armtronix/Wifi_Three_Triac_Board/Arduino_Code/Wifi_Triac_One_dimmable_Two_On_Off_V0.1/serverFunctions.ino

void initWiFi(){
  Serial.println();
  Serial.println();
  Serial.println("Startup");
  
  // test esid 
  WiFi.disconnect();
  delay(100);
  WiFi.mode(WIFI_STA);
  Serial.print("Connecting to WiFi ");
  Serial.println(esid);
  Debugln(epass);
  WiFi.begin((char*)esid.c_str(), (char*)epass.c_str());
  if ( testWifi() == 20 ) { 
      launchWeb(0);
      return;
  }
  Serial.println("Opening AP");
  setupAP();   
}

int testWifi(void) {
  int c = 0;
  Debugln("Wifi test...");  
  while ( c < 30 ) {
    if (WiFi.status() == WL_CONNECTED) { return(20); } 
    delay(500);
    Serial.print(".");    
    c++;
  }
  Serial.println("WiFi Connect timed out!");
  return(10);
} 


void setupAP(void) {
  
  WiFi.mode(WIFI_STA);
  WiFi.disconnect();
  delay(100);
  int n = WiFi.scanNetworks();
  Serial.println("scan done");
  if (n == 0){
    Serial.println("no networks found");
    st ="<b>No networks found:</b>";
  } else {
    Serial.print(n);
    Serial.println(" Networks found");
    st = "<ul>";
    for (int i = 0; i < n; ++i)
     {
      // Print SSID and RSSI for each network found
      Serial.print(i + 1);
      Serial.print(": ");
      Serial.print(WiFi.SSID(i));
      Serial.print(" (");
      Serial.print(WiFi.RSSI(i));
      Serial.print(")");
      Serial.println((WiFi.encryptionType(i) == ENC_TYPE_NONE)?" (OPEN)":"*");
      
      // Print to web SSID and RSSI for each network found
      st += "<li>";
      st +=i + 1;
      st += ": ";
      st += WiFi.SSID(i);
      st += " (";
      st += WiFi.RSSI(i);
      st += ")";
      st += (WiFi.encryptionType(i) == ENC_TYPE_NONE)?" (OPEN)":"*";
      st += "</li>";
      delay(10);
     }
    st += "</ul>";
  }
  Serial.println(""); 
  WiFi.disconnect();
  delay(100);
  WiFi.mode(WIFI_AP);

  
  WiFi.softAP(host);
  WiFi.begin(host); // not sure if need but works
  Serial.print("Access point started with name ");
  Serial.println(host);
  inApMode=1;
  launchWeb(1);
}

void launchWeb(int webtype) {
    Serial.println("");
    Serial.println("WiFi connected");    
    //Start the web server or MQTT
    if(otaFlag==1 && !inApMode){
      Serial.println("Starting OTA mode.");    
      Serial.printf("Sketch size: %u\n", ESP.getSketchSize());
      Serial.printf("Free size: %u\n", ESP.getFreeSketchSpace());
      MDNS.begin(host);
      server.on("/", HTTP_GET, [](){
        server.sendHeader("Connection", "close");
        server.sendHeader("Access-Control-Allow-Origin", "*");
        server.send(200, "text/html", otaServerIndex);
      });
      server.on("/update", HTTP_POST, [](){
        server.sendHeader("Connection", "close");
        server.sendHeader("Access-Control-Allow-Origin", "*");
        server.send(200, "text/plain", (Update.hasError())?"FAIL":"OK");
        setOtaFlag(0); 
        ESP.restart();
      },[](){
        HTTPUpload& upload = server.upload();
        if(upload.status == UPLOAD_FILE_START){
          //Serial.setDebugOutput(true);
          WiFiUDP::stopAll();
          Serial.printf("Update: %s\n", upload.filename.c_str());
          otaCount=300;
          uint32_t maxSketchSpace = (ESP.getFreeSketchSpace() - 0x1000) & 0xFFFFF000;
          if(!Update.begin(maxSketchSpace)){//start with max available size
            Update.printError(Serial);
          }
        } else if(upload.status == UPLOAD_FILE_WRITE){
          if(Update.write(upload.buf, upload.currentSize) != upload.currentSize){
            Update.printError(Serial);
          }
        } else if(upload.status == UPLOAD_FILE_END){
          if(Update.end(true)){ //true to set the size to the current progress
            Serial.printf("Update Success: %u\nRebooting...\n", upload.totalSize);
          } else {
            Update.printError(Serial);
          }
          Serial.setDebugOutput(false);
        }
        yield();
      });
      server.begin();
      Serial.printf("Ready! Open http://%s.local in your browser\n", host);
      MDNS.addService("http", "tcp", 80);
      otaTickLoop.attach(1, otaCountown);
    } else { 
      //setOtaFlag(1); 
      if (webtype==1 || iotMode==0){ //in config mode or WebControle
          if (webtype==1) {           
            webtypeGlob == 1;
            Serial.println(WiFi.softAPIP());
            server.on("/", webHandleConfig);
            server.on("/a", webHandleConfigSave);
            server.on("/gpio", webHandleGpio);//naren          
          } else {
            //setup DNS since we are a client in WiFi net
            if (!MDNS.begin(host)) {
              Serial.println("Error setting up MDNS responder!");
            } else {
              Serial.println("mDNS responder started");
              MDNS.addService("http", "tcp", 80);
            }          
            Serial.println(WiFi.localIP());
            server.on("/", webHandleRoot);  
            server.on("/cleareeprom", webHandleClearRom);
            server.on("/gpio", webHandleGpio);
          }
          //server.onNotFound(webHandleRoot);
          server.begin();
          Serial.println("Web server started");   
          webtypeGlob=webtype; //Store global to use in loop()
        } else if(webtype!=1 && iotMode==1){ // in MQTT and not in config mode     
          //mqttClient.setBrokerDomain((char*) mqttServer.c_str());//naren
          //mqttClient.setPort(1883);//naren
          mqttClient.setServer((char*) mqttServer.c_str(),1883);
          mqttClient.setCallback(mqtt_arrived);
          mqttClient.setClient(wifiClient);
          if (WiFi.status() == WL_CONNECTED){
            if (!connectMQTT()){
                delay(2000);
                if (!connectMQTT()){                            
                  Serial.println("Could not connect MQTT.");
                  Serial.println("Starting web server instead.");
                  iotMode=0;
                  launchWeb(0);
                  webtypeGlob=webtype;
                }
              }                    
            }
      }
    }
}

void webHandleConfig(){
  IPAddress ip = WiFi.softAPIP();
  String ipStr = String(ip[0]) + '.' + String(ip[1]) + '.' + String(ip[2]) + '.' + String(ip[3]);
  String s;
 
  s = "Configuration of " + hostName + " at ";
  s += ipStr;
  s += "<p><a href=\"/gpio\">Control GPIO</a><br />";
  s += st;
  s += "<form method='get' action='a'>";
  s += "<label>SSID: </label><input name='ssid' length=32><label> Pass: </label><input name='pass' type='password' length=64></br>";
  s += "The following is not ready yet!</br>";
  s += "<label>IOT mode: </label><input type='radio' name='iot' value='0'> HTTP<input type='radio' name='iot' value='1' checked> MQTT</br>";
  s += "<label>MQTT Broker IP/DNS: </label><input name='host' length=15></br>";
  s += "<label>MQTT Publish topic: </label><input name='pubtop' length=64></br>";
  s += "<label>MQTT Subscribe topic: </label><input name='subtop' length=64></br>";
  s += "<input type='submit'></form></p>";
  s += "\r\n\r\n";
  Serial.println("Sending 200");  
  server.send(200, "text/html", s); 
}

void webHandleConfigSave(){
  // /a?ssid=blahhhh&pass=poooo
  String s;
  s = "<p>Settings saved to eeprom and reset to boot into new settings</p>\r\n\r\n";
  server.send(200, "text/html", s); 
  Serial.println("clearing EEPROM.");
  clearConfig();
  String qsid; 
  qsid = server.arg("ssid");
  qsid.replace("%2F","/");
  Serial.println("Got SSID: " + qsid);
  esid = (char*) qsid.c_str();
  
  String qpass;
  qpass = server.arg("pass");
  qpass.replace("%2F","/");
  Serial.println("Got pass: " + qpass);
  epass = (char*) qpass.c_str();

  String qiot;
  qiot= server.arg("iot");
  Serial.println("Got iot mode: " + qiot);
  qiot=="0"? iotMode = 0 : iotMode = 1 ;
  
  String qsubTop;
  qsubTop = server.arg("subtop");
  qsubTop.replace("%2F","/");
  Serial.println("Got subtop: " + qsubTop);
  subTopic = (char*) qsubTop.c_str();
  
  String qpubTop;
  qpubTop = server.arg("pubtop");
  qpubTop.replace("%2F","/");
  Serial.println("Got pubtop: " + qpubTop);
  pubTopic = (char*) qpubTop.c_str();
  
  mqttServer = (char*) server.arg("host").c_str();
  Serial.print("Got mqtt Server: ");
  Serial.println(mqttServer);

  Serial.print("Settings written ");
  saveConfig()? Serial.println("sucessfully.") : Serial.println("not succesfully!");;
  Serial.println("Restarting!"); 
  delay(1000);
  ESP.reset();
}

void webHandleRoot(){
  String s;
  s = "<p>Hello from ESP8266";
  s += "</p>";
  s += "<a href=\"/gpio\">Controle GPIO</a><br />";
  s += "<a href=\"/cleareeprom\">Clear settings an boot into Config mode</a><br />";
  s += "\r\n\r\n";
  Serial.println("Sending 200");  
  server.send(200, "text/html", s); 
}

void webHandleClearRom(){
  String s;
  s = "<p>Clearing the config and reset to configure new wifi<p>";
  s += "</html>\r\n\r\n";
  Serial.println("Sending 200"); 
  server.send(200, "text/html", s); 
  Serial.println("clearing config");
  clearConfig();
  delay(10);
  Serial.println("Done, restarting!");
  ESP.reset();
}


void webHandleGpio(){
  String s;
  int state_sw;
  int state_dimmer;
  int state_triac_one;
  int state_triac_two;
   // Set GPIO according to the request
    if (server.arg("state_sw")=="1" || server.arg("state_sw")=="0" ) {
         state_sw = server.arg("state_sw").toInt();       
      if (state_sw == LOW)
      {
      Serial.println("Dimmer:0");
      }
      else
      {
      Serial.println("Dimmer:99");
      }
          
    }
   if (server.arg("state_triac_one")=="1" || server.arg("state_triac_one")=="0" ) 
     {
      state_triac_one = server.arg("state_triac_one").toInt();
      Serial.print("R_1 switched via web request to ");
      Serial.println(state_triac_one);      
     }
  if (server.arg("state_triac_two")=="1" || server.arg("state_triac_two")=="0" ) 
     {
      state_triac_two = server.arg("state_triac_two").toInt();
      Serial.print("R_2 switched via web request to ");
      Serial.println(state_triac_two);      
     }
   if (server.arg("state_dimmer") !="") {
      state_dimmer = server.arg("state_dimmer").toInt();
      //digitalWrite(BUILTIN_LED, state_triac_one);
     // Serial.print("Light switched via web request to  "); 
      Serial.print("Dimmer:");     
      Serial.println(state_dimmer); 
      dimming =127-state_dimmer;
      delay(5);   
    }
    s  = "<p>Three Triac Board</p>"; 
    s += "Dimmable TRIAC is now ";
    s += (state_dimmer)?"ON":"OFF";
    s += "<p>Change to <form action='gpio'><input type='radio' name='state_sw' value='1' ";
    s += (state_dimmer)?"checked":"";
    s += ">TRIAC_ON<input type='radio' name='state_sw' value='0' ";
    s += (state_dimmer)?"":"checked";
    s += ">TRIAC_OFF <input type='submit' value='Submit'></form></p>";  

    s += "Non Dimmable Triac One is now ";
    s += (state_triac_one)?"ON":"OFF";
    s += "<p>Change to <form action='gpio'><input type='radio' name='state_triac_one' value='1' ";
    s += (state_triac_one)?"checked":"";
    s += ">TRIAC_1_ON <input type='radio' name='state_triac_one' value='0' ";
    s += (state_triac_one)?"":"checked";
    s += ">TRIAC_1_OFF <input type='submit' value='Submit'></form></p>"; 

    s += "Non Dimmable Triac Two is now ";
    s += (state_triac_two)?"ON":"OFF";
    s += "<p>Change to <form action='gpio'><input type='radio' name='state_triac_two' value='1' ";
    s += (state_triac_two)?"checked":"";
    s += ">TRIAC_2_ON <input type='radio' name='state_triac_two' value='0' ";
    s += (state_triac_two)?"":"checked";
    s += ">TRIAC_2_OFF <input type='submit' value='Submit'></form></p>"; 
    
    s += "<p>Change to <form action='gpio' name='state' method='GET' oninput='showValue(state_dimmer.value)'><input type='range' name='state_dimmer' id='state_dimmer' min='0' max='90' step='5' value='0'  >" ; 
    s += "</form></p>";
    s += "<script type='text/javascript'>";
    s += "function showValue(dimming)";
    s += "{  document.querySelector('#state_dimmer').value=dimming ;";
    s += "   document.forms['state'].submit();";
    s += "}";
    s += "</script>";

   server.send(200, "text/html", s);
        
}
