armtronix/Wifi_Three_Triac_Board/Arduino_Code/Wifi_Triac_One_dimmable_Two_On_Off_V0.1/mqttFunctions.ino

boolean connectMQTT() {
  if (mqttClient.connected()) {
    return true;
  }

  Serial.print("Connecting to MQTT server ");
  Serial.print(mqttServer);
  Serial.print(" as ");
  Serial.println(host);

  if (mqttClient.connect(host)) {
    Serial.println("Connected to MQTT broker");
    if (mqttClient.subscribe((char*)subTopic.c_str())) {
      Serial.println("Subsribed to topic.");
    } else {
      Serial.println("NOT subsribed to topic!");
    }
    return true;
  }
  else {
    Serial.println("MQTT connect failed! ");
    return false;
  }
}

void disconnectMQTT() {
  mqttClient.disconnect();
}

void mqtt_handler() {
  if (toPub == 1) {
    Debugln("DEBUG: Publishing state via MQTT");
    if (pubState()) {
      toPub = 0;
    }
  }
  mqttClient.loop();
  delay(100); //let things happen in background
}

void mqtt_arrived(char* subTopic, byte* payload, unsigned int length) { // handle messages arrived
  int i = 0;
//  Serial.print("MQTT message arrived:  topic: " + String(subTopic));
  // create character buffer with ending null terminator (string)

  for (i = 0; i < length; i++) {
    buf[i] = payload[i];
  }
  buf[i] = '\0';
  String msgString = String(buf);
  Serial.println(" message: " + msgString);
  
  if (msgString.substring(0,6) == "R10_ON") 
  {
    Serial.println("Dimmer:99");
  } 
  else if (msgString.substring(0,7) == "R10_OFF") 
  {
    Serial.println("Dimmer:0");
  }
  else if (msgString.substring(0,6) == "R08_ON") 
  {
    Serial.println("R_1 switched via web request to 1");
  } 
  else if (msgString.substring(0,7) == "R08_OFF") 
  {
    Serial.println("R_1 switched via web request to 0");
  }
  else if (msgString.substring(0,6) == "R09_ON") 
  {
    Serial.println("R_2 switched via web request to 1");
  } 
  else if (msgString.substring(0,7) == "R09_OFF") 
  {
    Serial.println("R_2 switched via web request to 0");
  }
  else if (msgString.substring(0,7) == "Dimmer:")
  { 
       Serial.print("Dimmer:");
       Serial.println(msgString.substring(7,9));    
  }
}

boolean pubState() { //Publish the current state of the light
  if (!connectMQTT()) {
    delay(100);
    if (!connectMQTT) {
      Serial.println("Could not connect MQTT.");
      Serial.println("Publish state NOK");
      return false;
    }
  }
  if (mqttClient.connected()) 
  {
    Serial.println("To publish state " + state );
    if (mqttClient.publish((char*)pubTopic.c_str(), (char*) state.c_str())) {
      Serial.println("Publish state OK");
      return true;
    } 
    else 
    {
      Serial.println("Publish state NOK");
      return false;
    }
  } 
  else 
  {
    Serial.println("Publish state NOK");
    Serial.println("No MQTT connection.");
  }
}

String getValue(String data, char separator, int index)
{
  int found = 0;
  int strIndex[] = {
    0, -1
  };
  int maxIndex = data.length() - 1;
  for (int i = 0; i <= maxIndex && found <= index; i++) {
    if (data.charAt(i) == separator || i == maxIndex) {
      found++;
      strIndex[0] = strIndex[1] + 1;
      strIndex[1] = (i == maxIndex) ? i + 1 : i;
    }
  }
  return found > index ? data.substring(strIndex[0], strIndex[1]) : "";
}
